DavidGilmour1984/CanSat/PCB/Screenshot 2025-08-16 151356.jpg

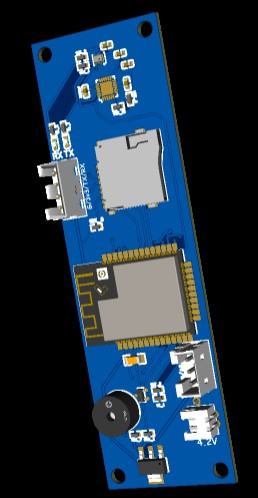
PCB/Screenshot 2025-08-16 151356.jpg
