DavidGilmour1984/CanSat/PCB/SCH_Schematic1_2025-08-16.pdf

# SD Card Buzzer

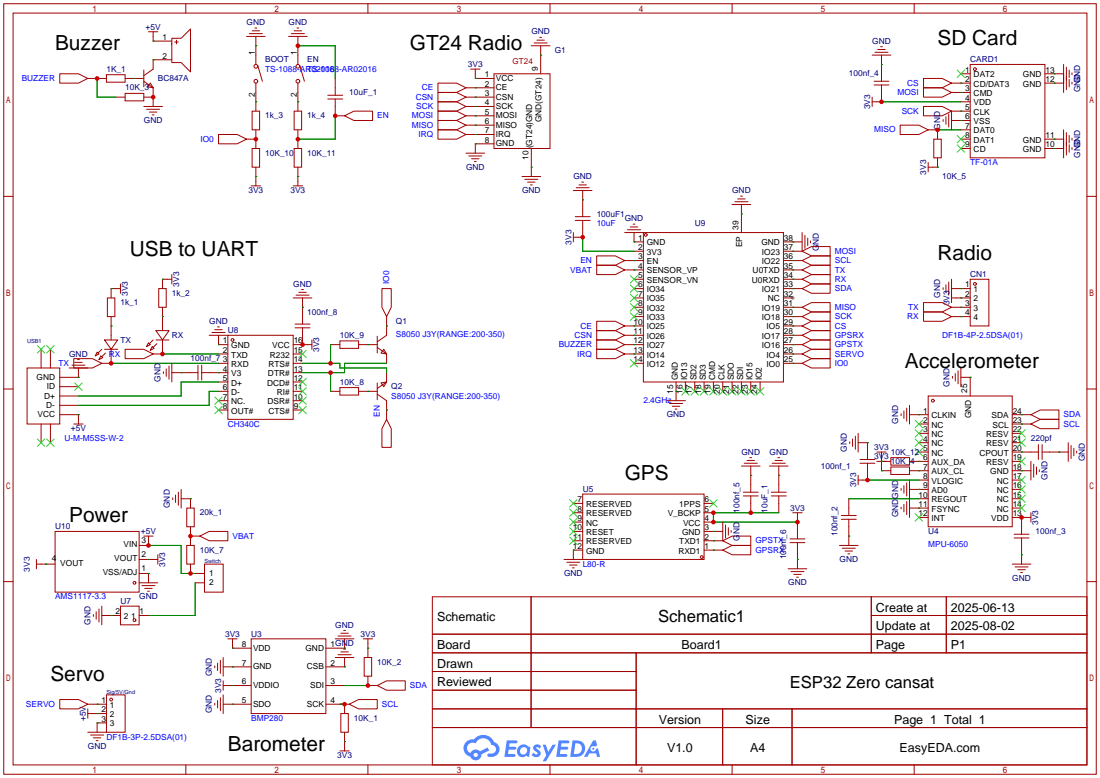
[picture p3: page 1]

DSR# 10 RI# 11 DCD# 12 DTR# 13 RTS# 14 R232 15 VCC 16

Schematic | Schematic1 | Create at | 2025-06-13

Update at | 2025-08-02

Board | Board1 | Page | P1
Drawn | | ESP32 Zero cansat
Reviewed

Version | Size | Page 1 Total 1
V1.0 | A4 | EasyEDA.com
