DavidGilmour1984/CanSat/(commit log)

2025-07-16 Update reduced data
    🚀 ESP32 Rocket Telemetry Logger
    This project is a high-speed data logger and telemetry system for rocketry applications, built on the ESP32 microcontroller. It captures environmental and positional data from multiple onboard sensors and logs it to an SD card at 10 Hz, while sending compressed telemetry packets via Serial every 2 seconds for real-time ground monitoring.
    📦 Features
    BMP280 Barometric Sensor
    Measures altitude and tracks peak altitude during flight.
    MPU6050 Accelerometer
    Records Z-axis acceleration (vertical) for detecting motion profiles.
    L80-R GPS Module (via UART)
    Continuously updates GPS position, altitude, and HDOP.
    SD Card Logging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
2025-07-16 Create ESP32cansat code
    This code implements a full-featured ESP32-based CanSat flight computer and telemetry system. It uses several sensors to track environmental and flight data and logs that information to an SD card while also broadcasting simplified telemetry via serial. Key features include:
    • Sensors:
    - BMP280 for measuring atmospheric pressure and altitude.
    - MPU6050 for accelerometer readings (Z-axis acceleration is used here).
    - L80-R GPS module via TinyGPS++ on UART1 for latitude, longitude, altitude, and HDOP accuracy.
    - Battery voltage monitoring via analog pin (with scaling for a voltage divider).
    • Output:
    - Logs data to a uniquely named CSV file on a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
2025-07-16 Update and rename reduced data to Ground station code
    This HTML + JavaScript code implements a serial telemetry dashboard for a CanSat. It uses the Web Serial API to connect to a COM port and visualize incoming telemetry data in real time. Key features and functionality include:
    • Purpose:
    - Provides a browser-based interface to monitor and interpret telemetry from an ESP32-powered CanSat.
    - Parses simplified serial packets formatted as:
    <BMP Altitude><SD Status A/B><Lat decimal digits><HDOP Grade><Lon decimal digits>
    Example: 154.2A654321C987654
    • UI Layout:
    - Two main sections:
    1. A left-hand side table displaying decoded telemetry values (altitude, SD ca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
2025-07-16 Rename Gerber_PCB1_2025-07-17.zip to Low transmit dat/Gerber_PCB1_2025-07-17.zip
2025-07-16 Rename ESP32cansat code to ESP32cansat code
2025-07-16 Rename Ground station code to Low transmit data/Ground station code
2025-07-16 Update Ground station code
2025-07-17 Update ESP32cansat code
    sd and mission status intefgrated
    HDOP dropped and replaced with a voltage given as a letter
2025-07-26 Update ESP32cansat code
    servo fix
2025-07-28 Create RP2040 Zero
    ⏱️ RP2040-Zero Servo Countdown with NeoPixel Rainbow
    This Arduino sketch runs on a Waveshare RP2040-Zero and performs a 60-second countdown using the onboard NeoPixel RGB LED, transitioning through a smooth rainbow gradient from indigo to red. At the end of the countdown, it activates a connected servo motor.
    ✨ Features
    Onboard NeoPixel gradually shifts color:
    Indigo → Blue → Cyan → Green → Yellow → Orange → Red
    After 60 seconds, a servo motor moves to a deployed position (90°)
    Designed for RP2040-Zero with minimal hardware
    🧰 Hardware Requirements
    Waveshare RP2040-Zero
    Micro servo connected to GPIO 15
    Uses onboard NeoPixel on G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
2025-08-02 Update Ground station code
    Buzzer reset fized and SD card wrtie fail fixed
2025-08-02 Update ESP32cansat code
    Voltage factor fixed
2025-08-02 Create Status symbols
    Mission anad battery status for base91 compression
2025-08-02 Create CanSat ESP32 code
    🛰️ ESP32 CanSat Telemetry System
    This project is a lightweight telemetry and logging system for an ESP32-based CanSat or high-altitude payload. It collects altitude, acceleration, battery voltage, GPS position, and mission status, and encodes them into a compact Base91 telemetry packet for efficient transmission and error checking.
    ✈️ Features
    Sensors Used:
    BMP280 for barometric altitude
    MPU6050 for vertical acceleration
    TinyGPS++ module for GPS position and GPS-based altitude
    Analog voltage sensing for battery level
    Optional buzzer and servo deployment system
    Telemetry Encoding:
    Uses Base91 encoding for compact data
    Fixed-width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
2025-08-02 Create Ground Station HTML
    🛰️ CanSat Telemetry Dashboard (Web Serial Parser)
    This HTML-based dashboard provides a clean, interactive interface for decoding and displaying real-time Base91-encoded telemetry packets sent from an ESP32-based CanSat or high-altitude system. It uses the Web Serial API to connect directly to the device over USB and parse compact telemetry packets into readable mission data.
    🔌 Web Serial Connection – No special drivers needed, just click "Connect"
    🔐 Base91 Decoder – Decodes fixed-width 14-character telemetry strings:
    2 chars – Transmission Counter
    2 chars – Altitude (meters)
    1 char – Combined Status (SD card, batte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
2025-08-02 Update Ground Station HTML
2025-08-03 Create transmitter code
    🔧 Typical Wiring for Transmit/Receive Mode
    Pin Connect to
    M1 GND
    M0 GND
    TXD ESP32 RX (e.g. GPIO 16)
    RXD ESP32 TX (e.g. GPIO 17)
    AUX Optional (to ESP32 input, e.g. GPIO 25)
    VCC 3.3V
    GND GND
2025-08-03 Create receiver code
    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
2025-08-03 Create HTML serial communication
    ✅ Simple HTML + JavaScript Page to Connect to Ebyte Module via Serial
    This example:
    Lets you connect to the Ebyte module via USB–Serial adapter.
    Allows you to send messages and view responses in the browser.
    ⚠️ Only works in Chrome/Edge and over HTTPS or localhost.
2025-08-08 Update ESP32cansat code
    No servo movement at start
2025-08-16 Rename Screenshot 2025-08-16 151356.jpg to PCB/Screenshot 2025-08-16 151356.jpg
2025-08-16 Rename Screenshot 2025-08-16 151416.jpg to PCB/Screenshot 2025-08-16 151416.jpg
2025-08-16 Rename ESP32cansat code to ESP32cansat code Low Data
2025-08-16 Update and rename base91/CanSat ESP32 code to Code/base91/CanSat ESP32 code
2025-08-16 Rename base91/Ground Station HTML to Code/base91/Ground Station HTML
2025-08-16 Rename Low transmit data/ESP32cansat code Low Data to Code/Low transmit data/ESP32cansat code Low Data
2026-07-30 Add programming guide for CanSat Flight Computer
    Added a comprehensive guide for programming the CanSat Flight Computer using the Arduino IDE, including setup instructions, board support installation, upload procedures, and troubleshooting tips.
2026-08-02 Update and rename Transmitter.ino to ESP32 Ground Station.ino
